Makerfabs/Maduino-Zero-SIM868-GPS-Tracker/README.md

# Maduino-Zero-SIM868-GPS-Tracker
Maduino Zero SIM868 GPS Tracker
