Makerfabs/Maduino-Zero-SIM868-GPS-Tracker/Spec/SIM868 Pin out（160120）.pdf

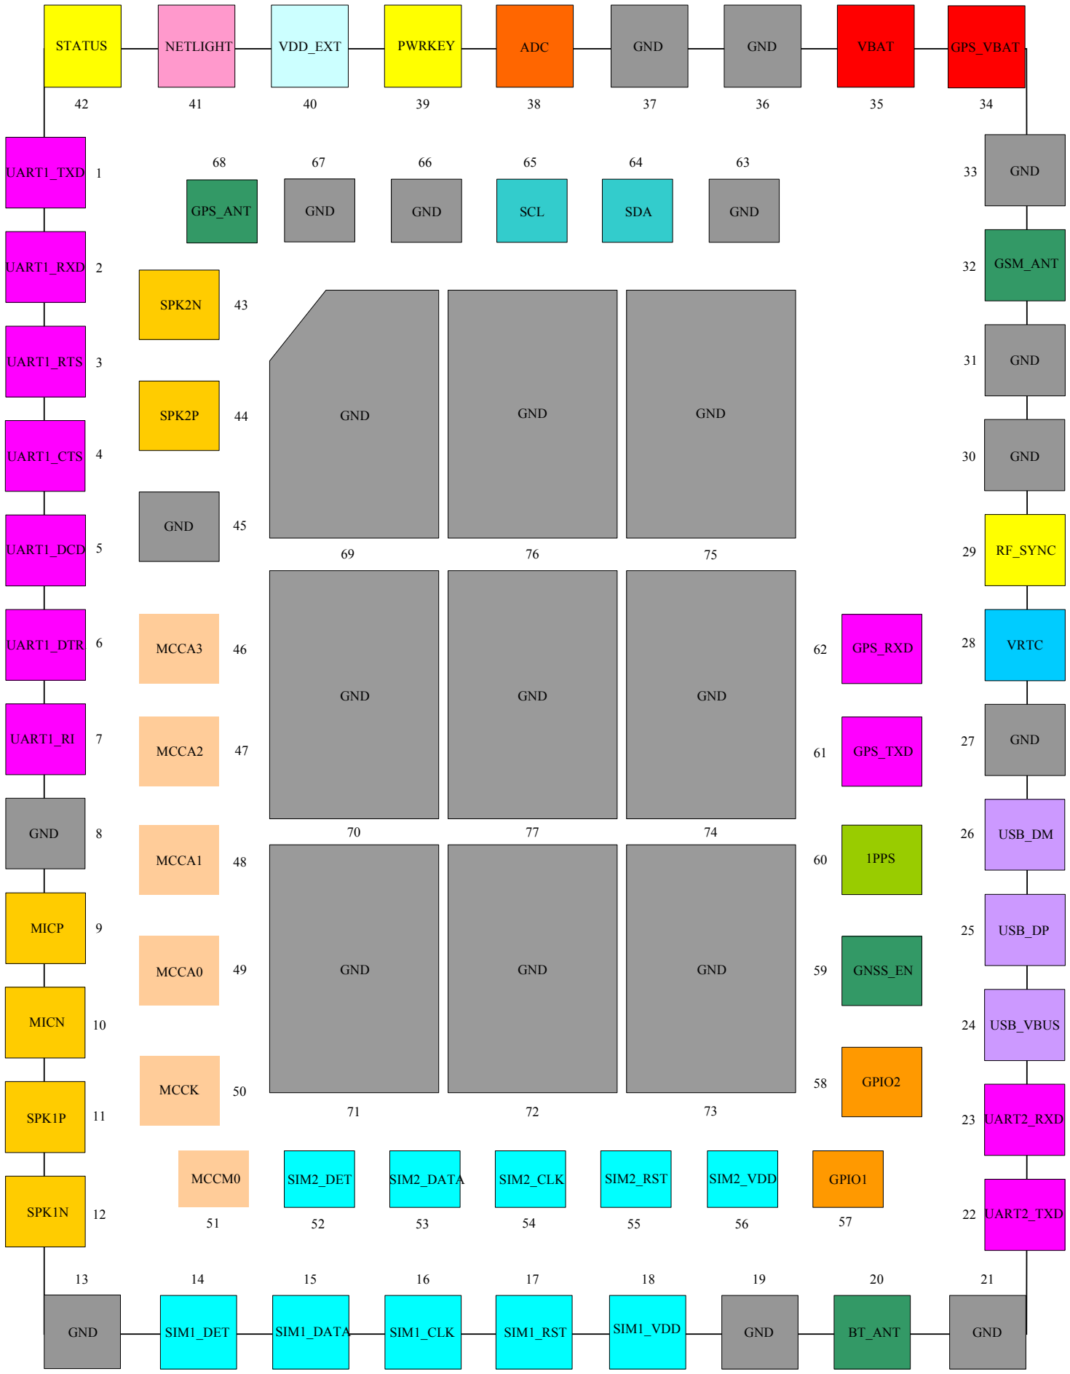
[picture p1: figure]
MCCK; UART1_DTR; USB_DP; ADC; VBAT; GPS_VBAT; UART1_RXD; PWRKEY; UART1_CTS; UART1_TXD; UART1_RTS; SCL; SDA; UART1_DCD; NETLIGHT; SIM1_DET; SIM1_DATA; SIM1_CLK; SIM1_RST; BT_ANT; SIM2_DET; SIM2_DATA; SIM2_CLK; SIM2_RST; SIM2_VDD; UART2_TXD; SPK1P; VRTC; MICP; MICN; USB_VBUS; USB_DM; GSM_ANT; STATUS; SIM1_VDD; MCCA3; GND; UART2_RXD; GPS_RXD; GNSS_EN; 1PPS; GPIO2; GPS_TXD; SPK1N; UART1_RI; GPS_ANT; VDD_EXT; GPIO1; RF_SYNC; SPK2P; MCCM0; MCCA1; SPK2N; MCCA2; MCCA0
