Makerfabs/Maduino-Zero-SIM868-GPS-Tracker/Spec/SIM868 Footprint（160310）.pdf

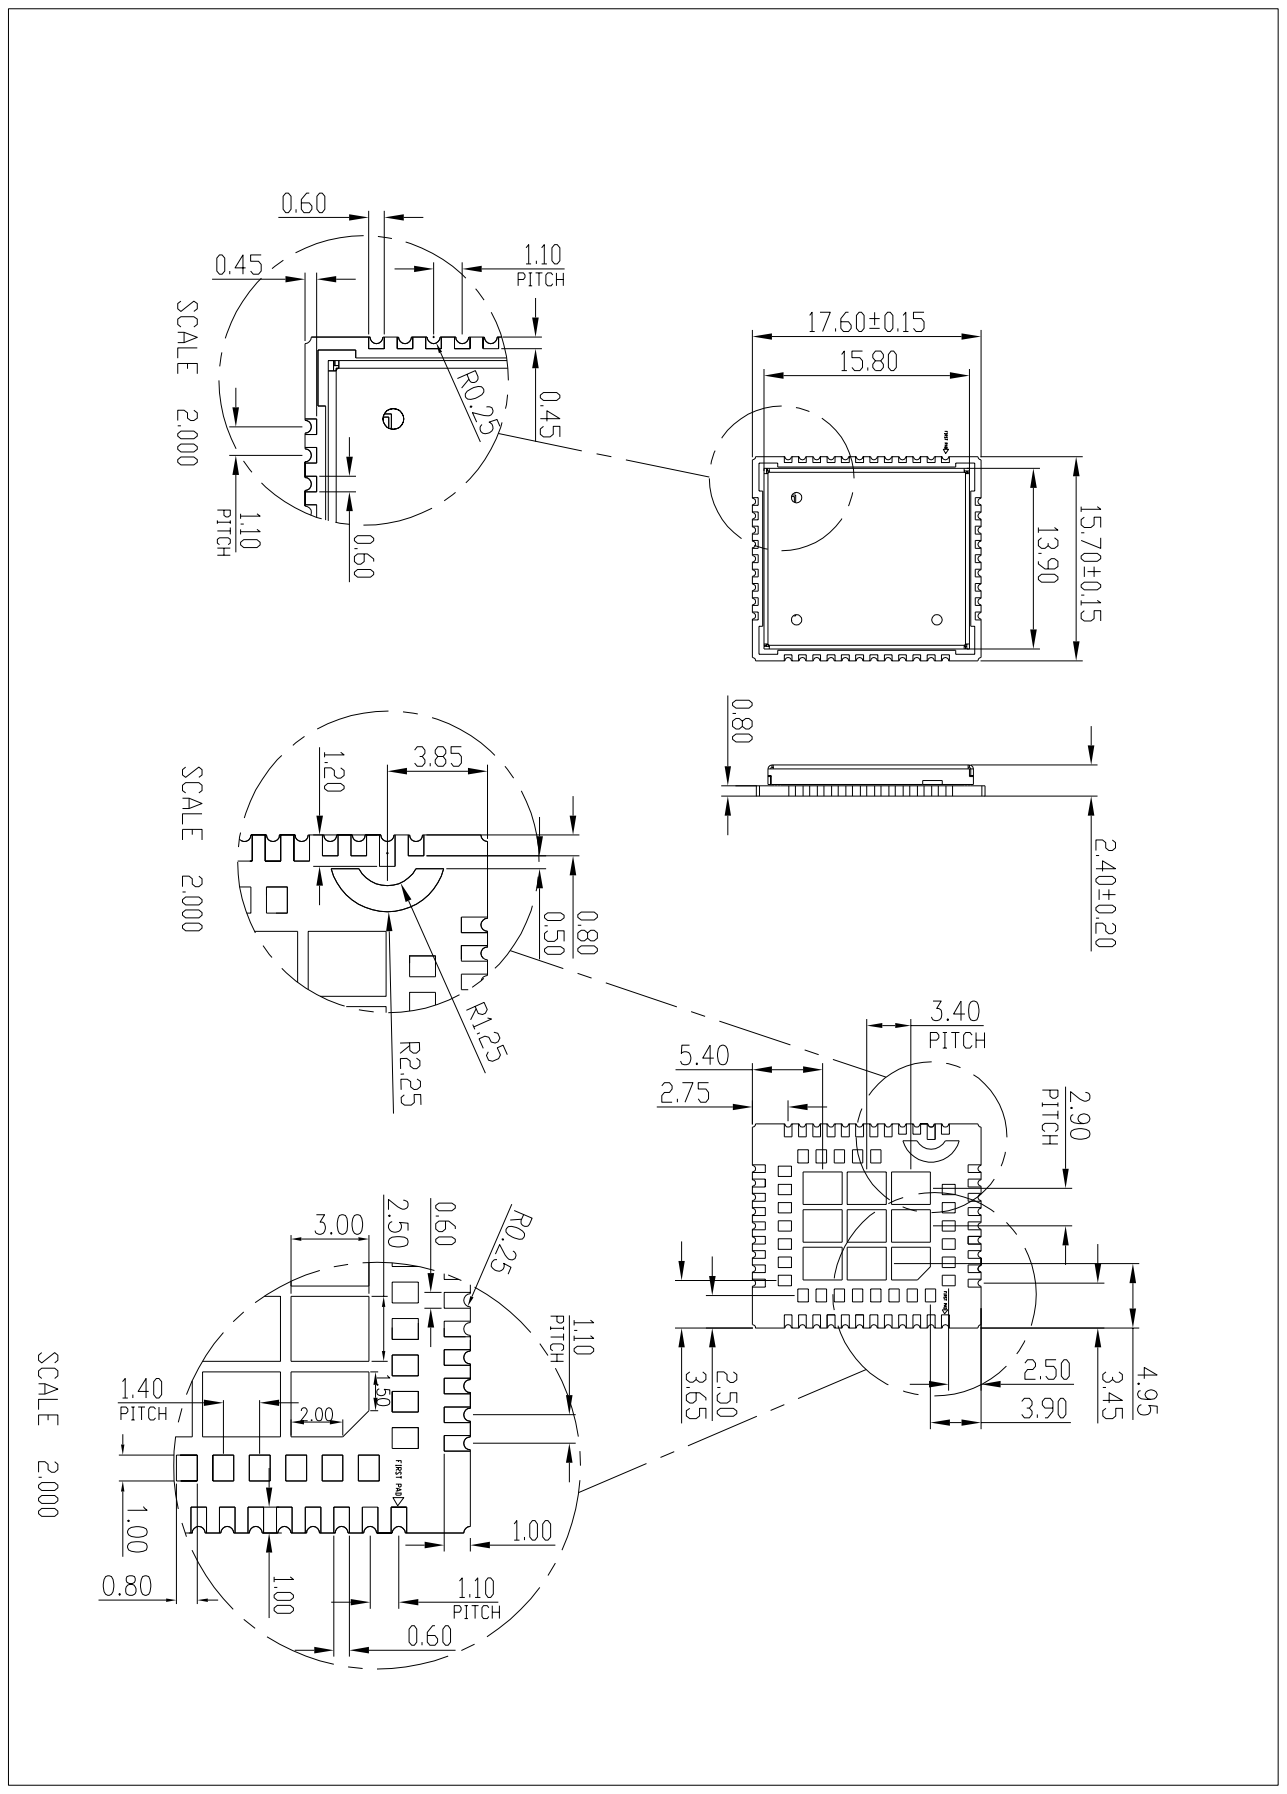
[picture p2: page 1]
