Makerfabs/Maduino-Zero-SIM868-GPS-Tracker/hardware/Maduino Zero SIM868 GPS Tracker v1.1.PDF

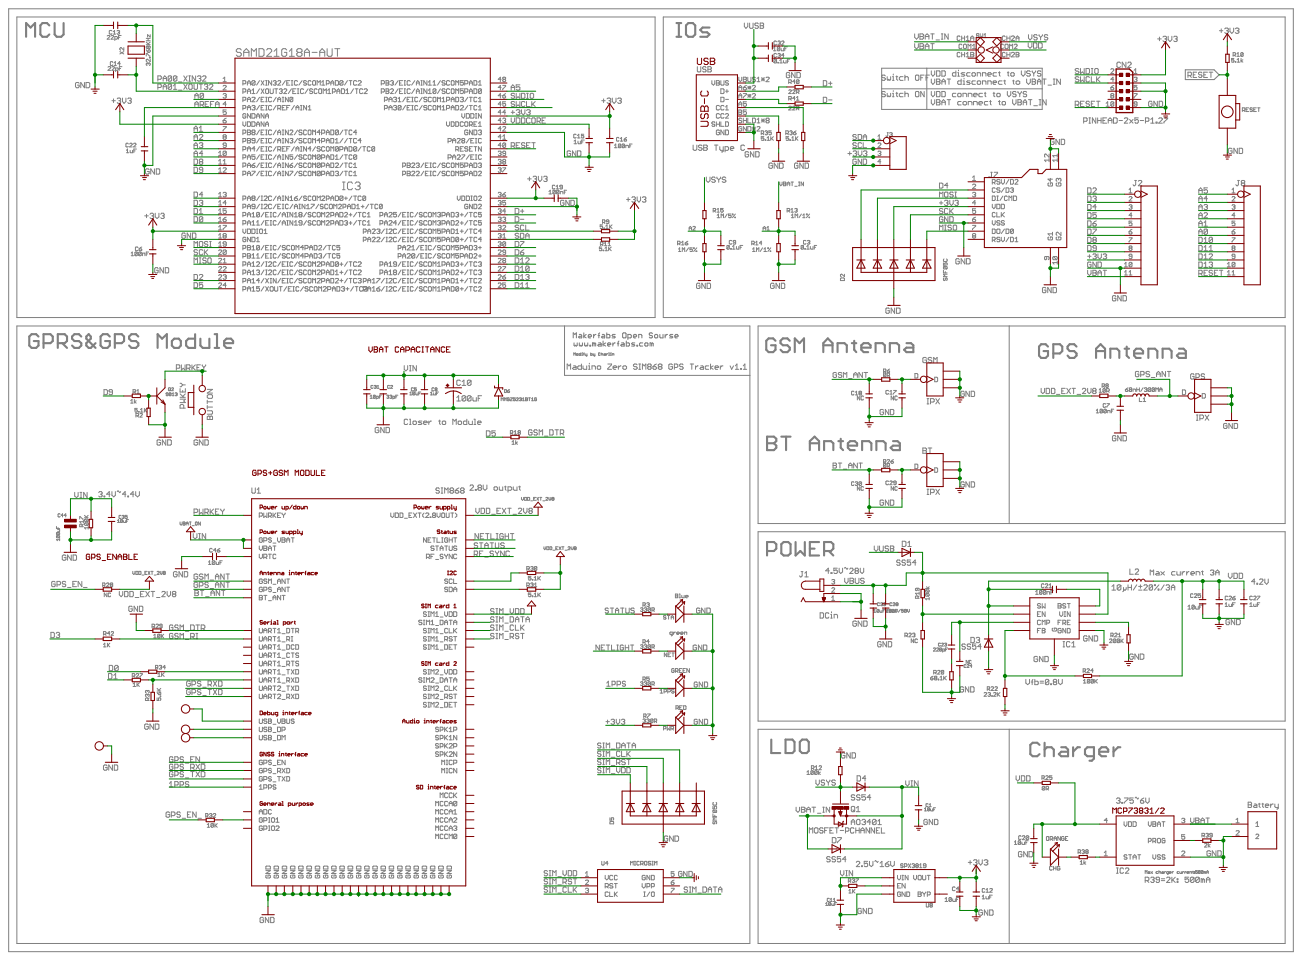
[picture p3: page 1]
