Makerfabs/Maduino-Zero-SIM868-GPS-Tracker/hardware/Maduino Zero SIM868 GPS Tracker v1.1.brd

## EAGLE design hardware/Maduino Zero SIM868 GPS Tracker v1.1.brd (2023-10-07)

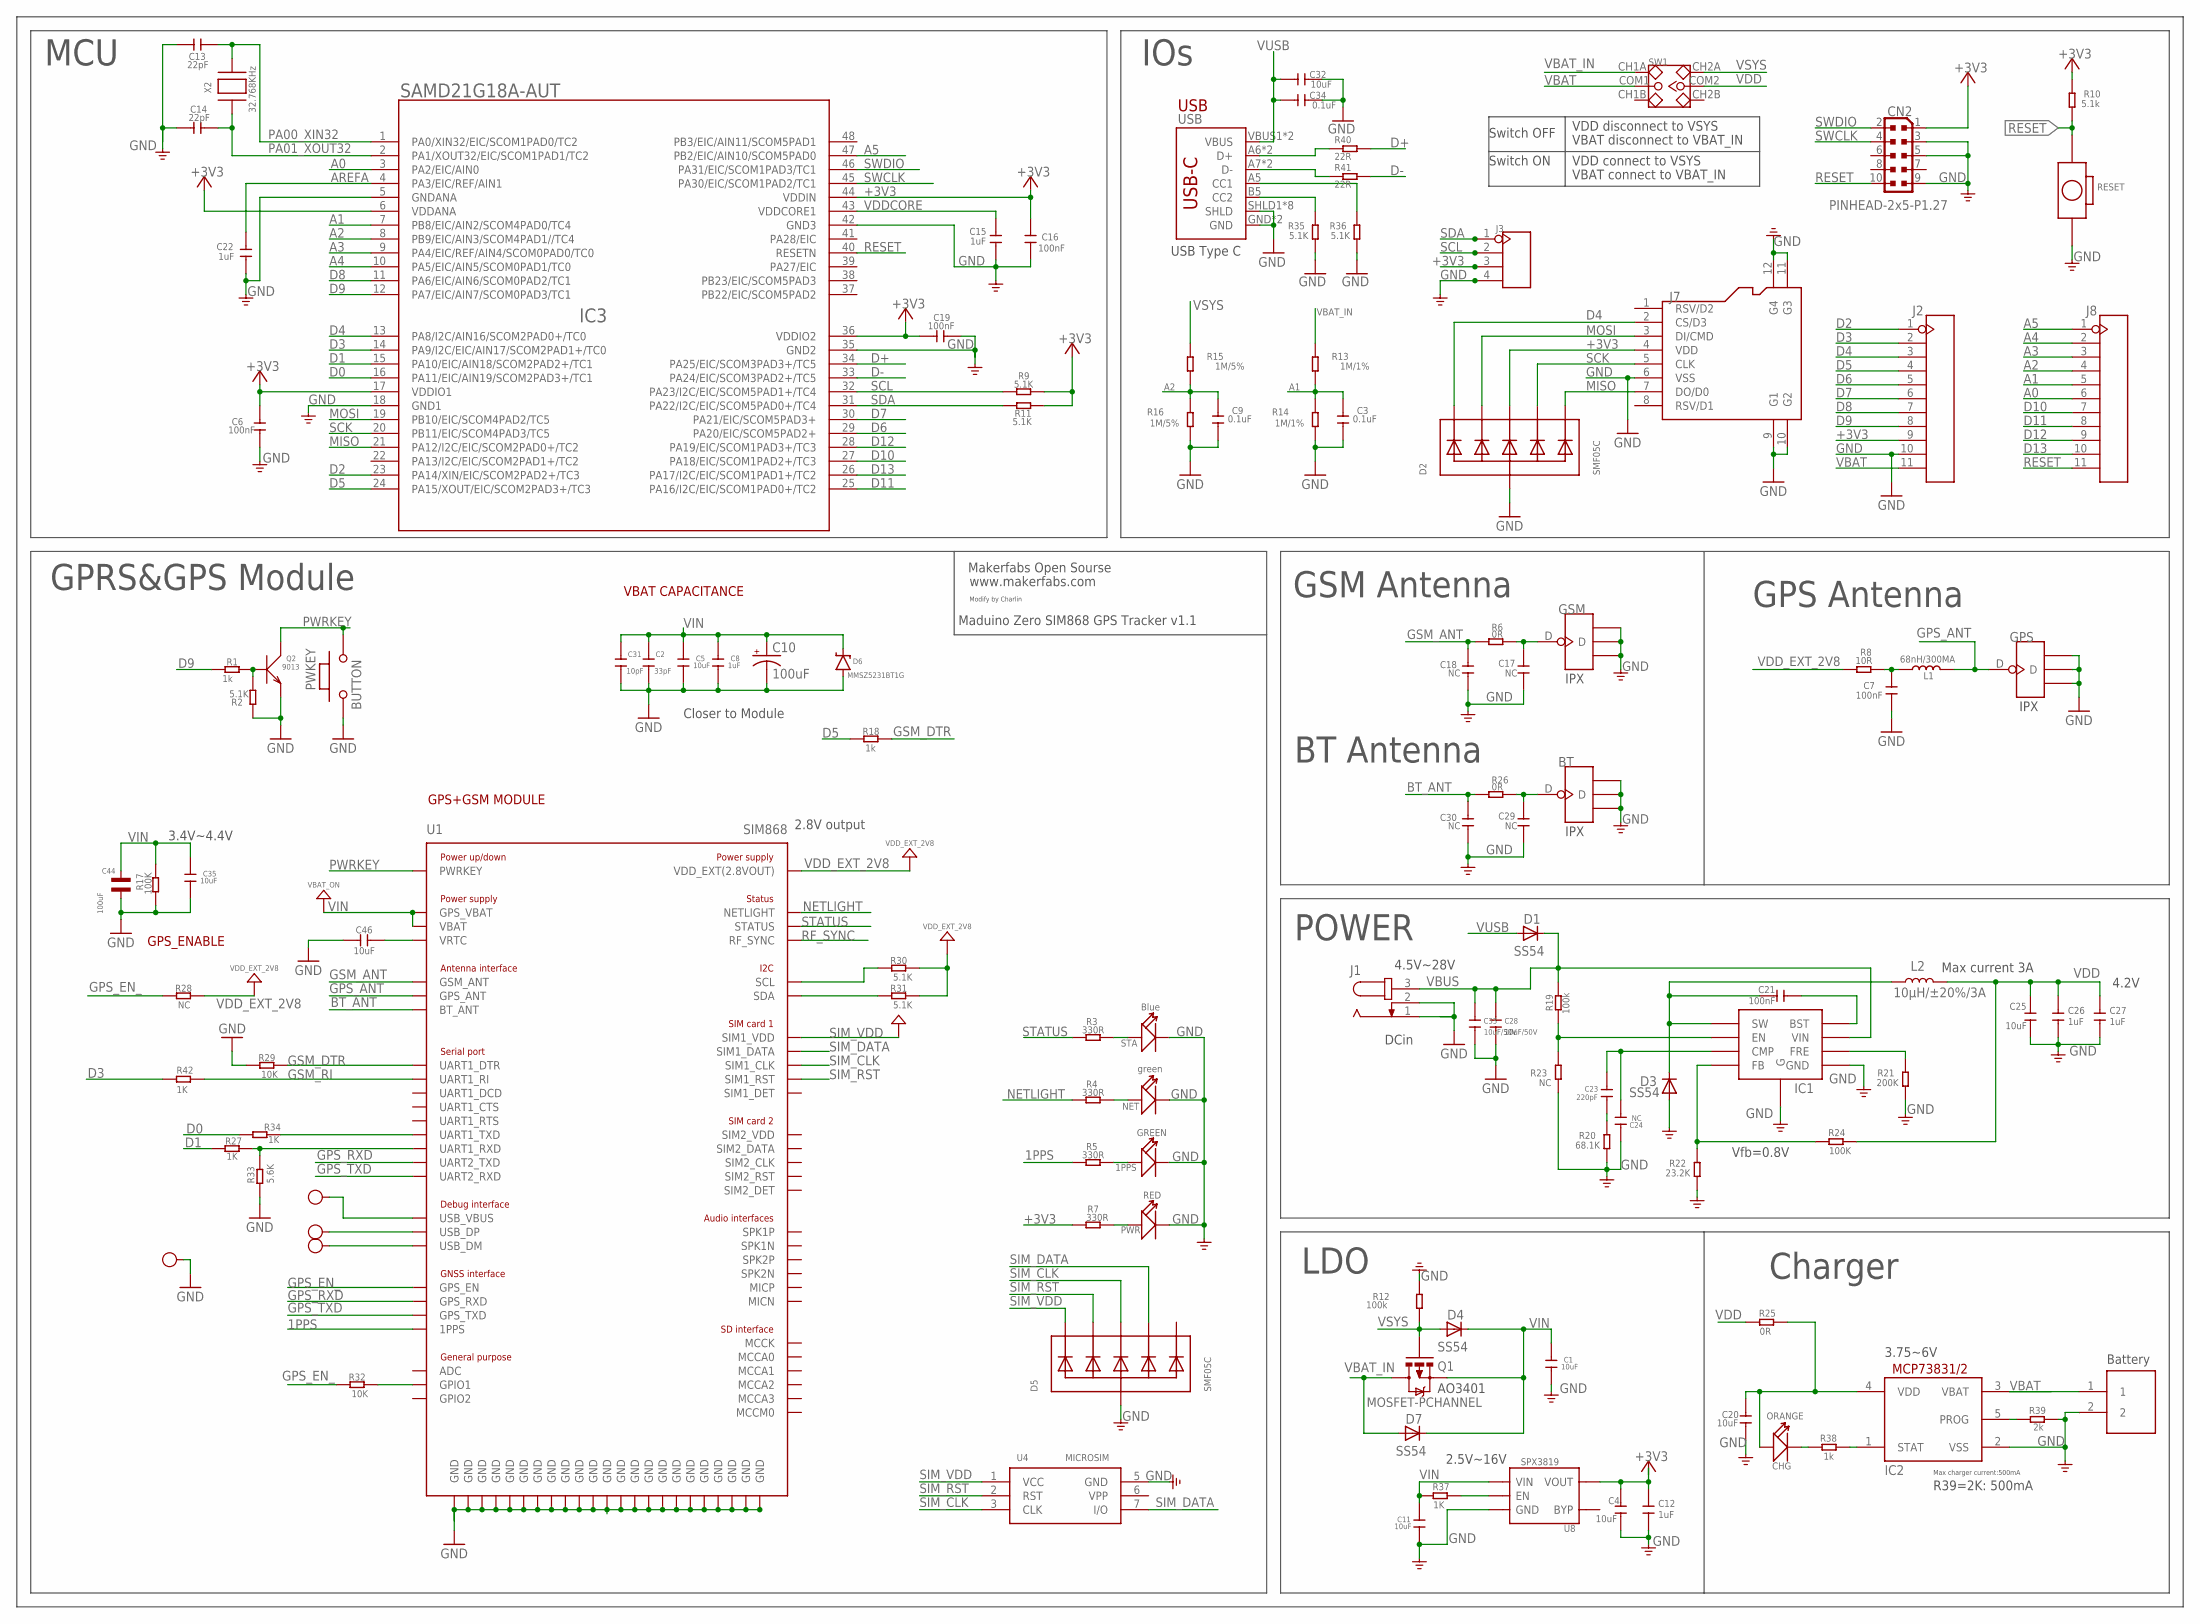
[picture p4: schematic Maduino Zero SIM868 GPS Tracker v1.1.sch]

Parts:
1PPS: GREEN; LED-0603
BT: ANTENNA-U-FL; 4P-U-FL
C1, C4, C5, C11, C20, C25, C32, C35: 10uF; 0603
C2: 33pF; 0603
C3, C9, C34: 0.1uF; 0603
C6, C7, C16, C19, C21: 100nF; 0603
C8, C12, C15, C22, C26, C27: 1uF; 0603
C10: 100uF; EIA3528
C13, C14: 22pF; 0603
C17, C18, C29, C30: NC; 0402
C23: 220pF; 0603
C24: NC; 0603
C28, C33: 10uF/50V; 0603
C31: 10pF; 0603
C44: 100uF; C1206; MPN CL31A107MQHNNNE
C46: 10uF; 0805
CHG: ORANGE; D0603
CN2: PINHEAD-2x5-P1.27; PINHEAD_2X05_127
D1, D3, D4, D7: SS54; DO-214AC
D2, D5: SMF05C; SOT363
D6: MMSZ5231BT1G; SOD-123
DN: TEST-POINT'4545'; TP-D45MIL; PARTNO DNP
DP: TEST-POINT'4545'; TP-D45MIL; PARTNO DNP
GND20: TEST-POINT'4545'; TP-D45MIL; PARTNO DNP
GPS: ANTENNA-U-FL; 4P-U-FL
GSM: ANTENNA-U-FL; 4P-U-FL
IC1: MP1584; SOIC8E
IC2: MCP73831/OT; SOT23-5L
IC3: SAMD21G18A-AUT; TQFP48-7X7
J1: JACK-PLUG1; SPC4078
J2, J8: HEADER-11P-2.54; 11P-2.54
J3: HEADER-4P-60/35MILROUND; 4P-65/35ROUND
J6: PH2.0-2P-90-DIP
J7: HOLDER-MICROSD-8P; 8P-SMD
L1: 68nH/300MA; L0603
L2: 10µH/±20%/3A; SRN6045
NET: green; LED-0603
PWKEY: BUTTON; 157SW
PWR: RED; LED-0603
Q1: MOSFET-PCHANNEL; SOT23-3
Q2: 9013; SOT23
R1, R18, R38: 1k; R0603
R2, R9, R11, R30, R31, R35, R36: 5.1K; R0603
R3, R4, R5, R7: 330R; R0603
R6, R25, R26: 0R; R0603
R8: 10R; R0603
R10: 5.1k; R0603
R12, R19: 100k; R0603
R13, R14: 1M/1%; R0603
R15, R16: 1M/5%; R0603
R17, R24: 100K; R0603
R20: 68.1K; R0603
R21: 200K; R0603
R22: 23.2K; R0603
R23, R28: NC; R0603
R27, R34, R37, R42: 1K; R0603
R29, R32: 10K; R0603
R33: 5.6K; R0603
R39: 2k; R0603
R40, R41: 22R; R0603
RESET: BOTTON-2P-90D; 2P-7.62X3.56-90D
STA: Blue; LED-0603
SW1: SWITCH-2CH-6P; 6P-2CH-2.54-7.6X3.0
U1: SIM868; MPN SIM868
U4: MICROSIM
U8: SPX3819; SOT23-5
USB: USB_C5; USB-C-16P-5
VUSB: TEST-POINT'4545'; TP-D45MIL; PARTNO DNP
X2: 32.768KHz; XTAL3215

Connections:
1PPS: R5.1, U1.60_ (1PPS)
+3V3: C4.2, C6.2, C12.2, C16.1, C19.1, CN2.1, D2.4 (C3), IC3.6 (VDDANA), IC3.17 (VDDIO1), IC3.36 (VDDIO2), IC3.44 (VDDIN), J2.9, J3.3, J7.4 (VDD), R7.1, R9.2, R10.2, R11.2, U8.5 (VOUT)
A0: IC3.3 (PA2/EIC/AIN0), J8.6
A1: C3.1, IC3.7 (PB8/EIC/AIN2/SCOM4PAD0/TC4), J8.5, R13.1, R14.2
A2: C9.1, IC3.8 (PB9/EIC/AIN3/SCOM4PAD1//TC4), J8.4, R15.1, R16.2
A3: IC3.9 (PA4/EIC/REF/AIN4/SCOM0PAD0/TC0), J8.3
A4: IC3.10 (PA5/EIC/AIN5/SCOM0PAD1/TC0), J8.2
A5: IC3.47 (PB2/EIC/AIN10/SCOM5PAD0), J8.1
AREFA: C22.1, IC3.4 (PA3/EIC/REF/AIN1)
BT_ANT: C30.2, R26.1, U1.20_ (BT_ANT)
D0: IC3.16 (PA11/EIC/AIN19/SCOM2PAD3+/TC1), R34.1
D1: IC3.15 (PA10/EIC/AIN18/SCOM2PAD2+/TC1), R27.1
D2: IC3.23 (PA14/XIN/EIC/SCOM2PAD2+/TC3), J2.1
D3: IC3.14 (PA9/I2C/EIC/AIN17/SCOM2PAD1+/TC0), J2.2, R42.1
D4: D2.1 (C1), IC3.13 (PA8/I2C/AIN16/SCOM2PAD0+/TC0), J2.3, J7.2 (CS/D3)
D5: IC3.24 (PA15/XOUT/EIC/SCOM2PAD3+/TC3), J2.4, R18.1
D6: IC3.29 (PA20/EIC/SCOM5PAD2+), J2.5
D7: IC3.30 (PA21/EIC/SCOM5PAD3+), J2.6
D8: IC3.11 (PA6/EIC/AIN6/SCOM0PAD2/TC1), J2.7
D9: IC3.12 (PA7/EIC/AIN7/SCOM0PAD3/TC1), J2.8, R1.1
D10: IC3.27 (PA18/EIC/SCOM1PAD2+/TC3), J8.7
D11: IC3.25 (PA16/I2C/EIC/SCOM1PAD0+/TC2), J8.8
D12: IC3.28 (PA19/EIC/SCOM1PAD3+/TC3), J8.9
D13: IC3.26 (PA17/I2C/EIC/SCOM1PAD1+/TC2), J8.10
D+: IC3.34 (PA25/EIC/SCOM3PAD3+/TC5), R40.1
D-: IC3.33 (PA24/EIC/SCOM3PAD2+/TC5), R41.1
GND: 1PPS.-, BT.GND1, BT.GND2, BT.GND3, C1.1, C2.1, C3.2, C4.1, C5.1, C6.1, C7.1, C8.1, C9.2, C10.C (-), C11.1, C12.1, C13.2, C14.2, C15.2, C16.2, C17.1, C18.1, C19.2, C20.1, C22.2, C24.2, C25.1, C26.1, C27.1, C28.2, C29.1, C30.1, C31.1, C32.2, C33.2, C34.2, C35.1, C44.P$2, C46.2, CN2.3, CN2.5, CN2.9, D2.2 (A), D3.A, D5.2 (A), D6.A, GND20.T, GPS.GND1, GPS.GND2, GPS.GND3, GSM.GND1, GSM.GND2, GSM.GND3, IC1.P$5 (GND), IC1.P$9 (G), IC2.2 (VSS), IC3.5 (GNDANA), IC3.18 (GND1), IC3.35 (GND2), IC3.42 (GND3), J1.1, J1.2, J2.10, J3.4, J6.2, J7.6 (VSS), J7.9 (G1), J7.10 (G2), J7.11 (G3), J7.12 (G4), NET.-, PWKEY.1, PWR.-, Q2.2 (E), R2.2, R12.2, R14.1, R16.1, R17.1, R20.1, R21.1, R22.1, R23.1, R29.1, R33.1, R35.1, R36.1, R39.2, RESET.P$2 (2), STA.-, U1.8_ (GND), U1.13_ (GND), U1.19_ (GND), U1.21_ (GND), U1.27_ (GND), U1.30_ (GND), U1.31_ (GND), U1.33_ (GND), U1.36_ (GND), U1.37_ (GND), U1.45_ (GND), U1.63_ (GND), U1.66_ (GND), U1.67_ (GND), U1.69_ (GND), U1.70_ (GND), U1.71_ (GND), U1.72_ (GND), U1.73_ (GND), U1.74_ (GND), U1.75_ (GND), U1.76_ (GND), U1.77_ (GND), U4.5 (GND), U8.2 (GND), USB.GND, USB.GND2 (GND), USB.SHLD1 (SHLD), USB.SHLD2 (SHLD), USB.SHLD3 (SHLD), USB.SHLD4 (SHLD), USB.SHLD5 (SHLD), USB.SHLD6 (SHLD), USB.SHLD7 (SHLD), USB.SHLD8 (SHLD)
GPS_ANT: GPS.D, L1.2, U1.68_ (GPS_ANT)
GPS_EN_: R28.1, R32.1, U1.59_ (GPS_EN)
GPS_RXD: U1.22_ (UART2_TXD), U1.62_ (GPS_RXD)
GPS_TXD: U1.23_ (UART2_RXD), U1.61_ (GPS_TXD)
GSM_ANT: C18.2, R6.1, U1.32_ (GSM_ANT)
GSM_DTR: R18.2, R29.2, U1.6_ (UART1_DTR)
GSM_RI: R42.2, U1.7_ (UART1_RI)
MISO: D2.6 (C5), IC3.21 (PA12/I2C/EIC/SCOM2PAD0+/TC2), J7.7 (DO/D0)
MOSI: D2.3 (C2), IC3.19 (PB10/EIC/SCOM4PAD2/TC5), J7.3 (DI/CMD)
unnamed: NET.+, R4.2
unnamed: 1PPS.+, R5.2
unnamed: PWR.+, R7.2
unnamed: R31.1, U1.64_ (SDA)
unnamed: C21.1, D3.C, IC1.P$1 (SW), L2.1
unnamed: C21.2, IC1.P$8 (BST)
unnamed: R3.2, STA.+
unnamed: C20.2, CHG.+, IC2.4 (VDD), R25.2
unnamed: IC1.P$4 (FB), R22.2, R24.1
unnamed: C23.2, C24.1, IC1.P$3 (CMP)
unnamed: C23.1, R20.2
unnamed: BT.D, C29.2, R26.2
unnamed: IC1.P$6 (FRE), R21.2
unnamed: IC1.P$2 (EN), R19.1, R23.2
unnamed: R30.1, U1.65_ (SCL)
unnamed: R27.2, R33.2, U1.2_ (UART1_RXD)
unnamed: R34.2, U1.1_ (UART1_TXD)
unnamed: R32.2, U1.57_ (GPIO1)
unnamed: U1.24_ (USB_VBUS), VUSB.T
unnamed: C7.2, L1.1, R8.2
unnamed: DP.T, U1.25_ (USB_DP)
unnamed: DN.T, U1.26_ (USB_DM)
unnamed: R37.2, U8.3 (EN)
unnamed: CHG.-, R38.1
unnamed: IC2.1 (STAT), R38.2
unnamed: R36.2, USB.A5 (CC1)
unnamed: R35.2, USB.B5 (CC2)
unnamed: C46.1, U1.28_ (VRTC)
unnamed: IC2.5 (PROG), R39.1
unnamed: R40.2, USB.A6 (D+), USB.B6 (D+)
unnamed: R41.2, USB.A7 (D-), USB.B7 (D-)
unnamed: Q2.1 (B), R1.2, R2.1
unnamed: C17.2, GSM.D, R6.2
NETLIGHT: R4.1, U1.41_ (NETLIGHT)
P$1: R30.2, R31.2
PA00_XIN32: C13.1, IC3.1 (PA0/XIN32/EIC/SCOM1PAD0/TC2), X2.P$2
PA01_XOUT32: C14.1, IC3.2 (PA1/XOUT32/EIC/SCOM1PAD1/TC2), X2.P$1
PWRKEY: PWKEY.2, Q2.3 (C), U1.39_ (PWRKEY)
RESET: CN2.10, IC3.40 (RESETN), J8.11, R10.1, RESET.P$1 (1)
RF_SYNC: U1.29_ (RF_SYNC)
SCK: D2.5 (C4), IC3.20 (PB11/EIC/SCOM4PAD3/TC5), J7.5 (CLK)
SCL: IC3.32 (PA23/I2C/EIC/SCOM5PAD1+/TC4), J3.2, R9.1
SDA: IC3.31 (PA22/I2C/EIC/SCOM5PAD0+/TC4), J3.1, R11.1
SIM2_VDD: U1.56_ (SIM2_VDD)
SIM_CLK: D5.4 (C3), U1.16_ (SIM1_CLK), U4.3 (CLK)
SIM_DATA: D5.5 (C4), U1.15_ (SIM1_DATA), U4.7 (I/O)
SIM_RST: D5.3 (C2), U1.17_ (SIM1_RST), U4.2 (RST)
SIM_VDD: D5.1 (C1), U1.18_ (SIM1_VDD), U4.1 (VCC)
STATUS: R3.1, U1.42_ (STATUS)
SWCLK: CN2.4, IC3.45 (PA30/EIC/SCOM1PAD2/TC1)
SWDIO: CN2.2, IC3.46 (PA31/EIC/SCOM1PAD3/TC1)
VBAT: IC2.3 (VBAT), J2.11, J6.1, SW1.COM1
VBAT_IN: D7.A, Q1.3 (D), R13.2, SW1.CH1A
VBUS: C28.1, C33.1, D1.C, IC1.P$7 (VIN), J1.3, R19.2
VDD: C25.2, C26.2, C27.2, L2.2, R24.2, R25.1, SW1.COM2
VDDCORE: C15.1, IC3.43 (VDDCORE1)
VDD_EXT_2V8: R8.1, R28.2, U1.40_ (VDD_EXT(2.8VOUT))
VIN: C1.2, C2.2, C5.2, C8.2, C10.A (+), C11.2, C31.2, C35.2, C44.P$1, D4.C, D6.C, D7.C, Q1.2 (S), R17.2, R37.1, U1.34_ (GPS_VBAT), U1.35_ (VBAT), U8.1 (VIN)
VSYS: D4.A, Q1.1 (G), R12.1, R15.2, SW1.CH2A
VUSB: C32.1, C34.1, D1.A, USB.VBUS1 (VBUS), USB.VBUS2 (VBUS)

Notes on the sheet:
GPS Antenna
GSM Antenna
GPRS&GPS Module
LDO
Max charger current:500mA
Charger
Makerfabs Open Sourse
www.makerfabs.com
Modify by Charlin
Maduino Zero SIM868 GPS Tracker v1.1
IOs
MCU
IPX
Battery
AO3401
Closer to Module
Switch OFF
Switch ON
VDD disconnect to VSYS
VBAT disconnect to VBAT_IN
VDD connect to VSYS
VBAT connect to VBAT_IN
4.2V
Max current 3A
DCin
4.5V~28V
R39=2K: 500mA
3.75~6V
Vfb=0.8V
2.5V~16V
GPS+GSM MODULE
GPS_ENABLE
VBAT CAPACITANCE
3.4V~4.4V
2.8V output
USB
USB Type C
BT Antenna
POWER

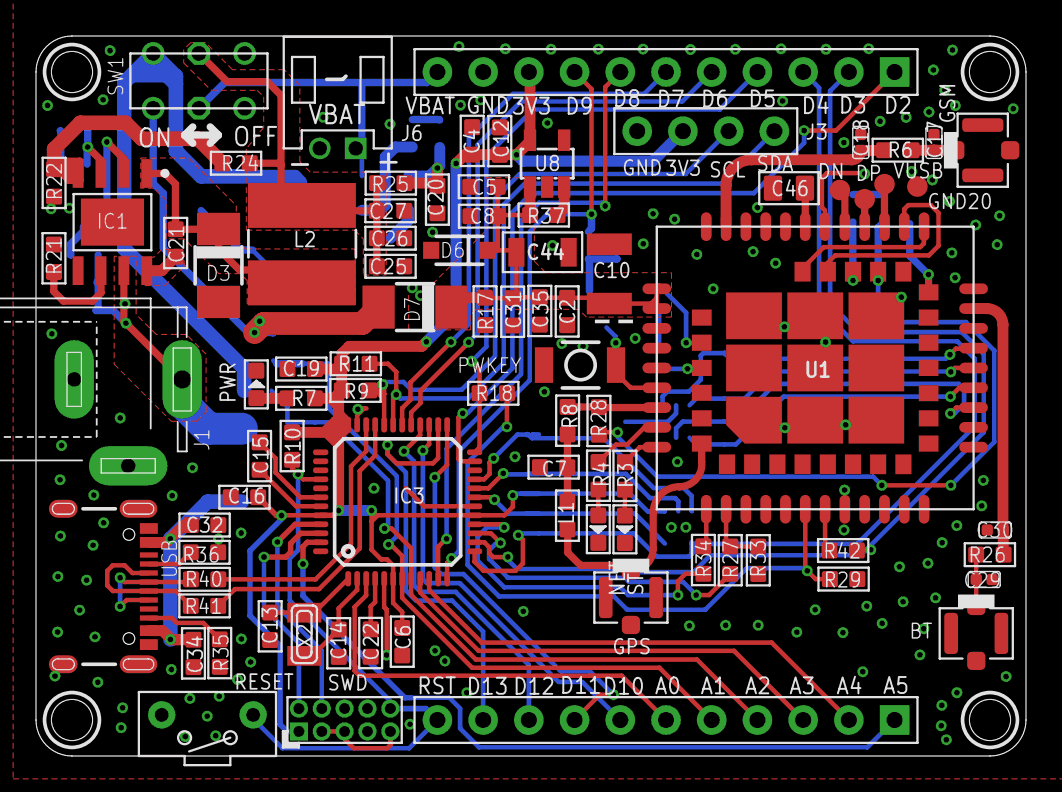
[picture p5: board Maduino Zero SIM868 GPS Tracker v1.1.brd from above]

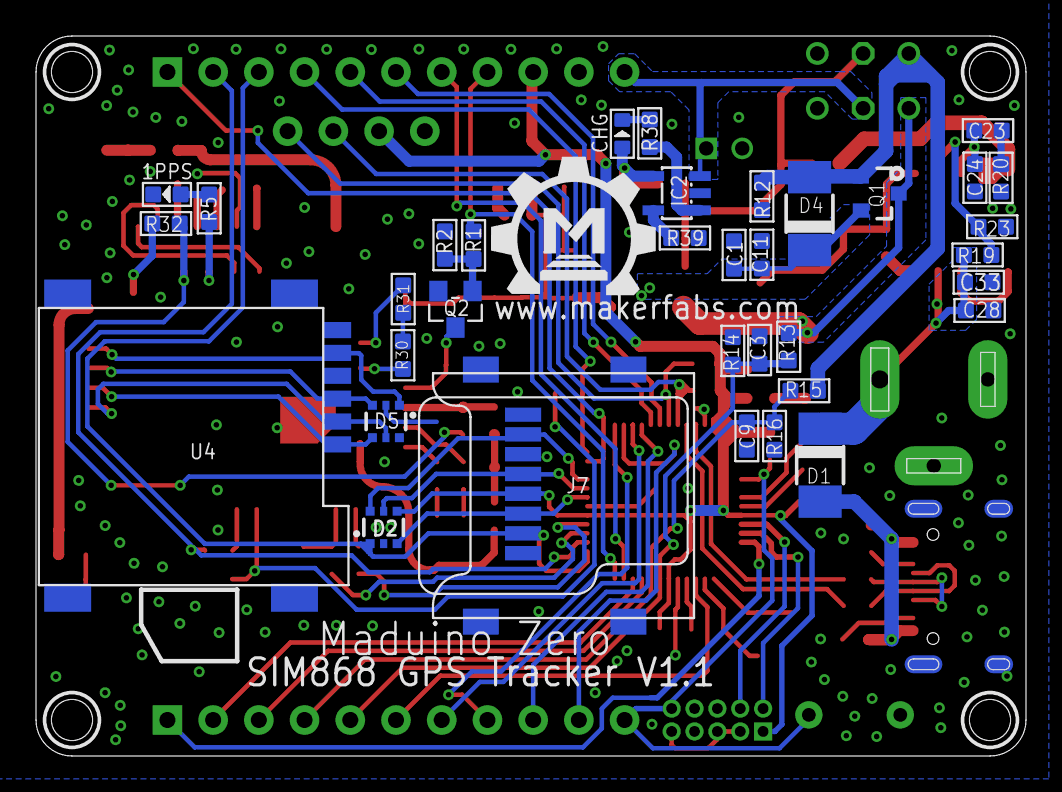
[picture p6: board Maduino Zero SIM868 GPS Tracker v1.1.brd from below]

Board: 2 copper layers, 55.0 x 40.0 mm, 121 parts (36 on the bottom side), 94 nets.

Other parts of the board:
U$1: MAKERFABS_0.3
